John-Wright-alt/hospital_robot/hospital_robot_description/meshes/lidar.stl

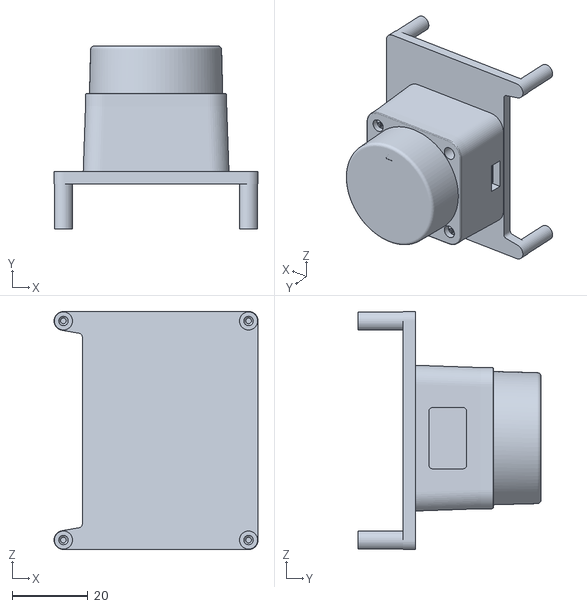
[picture p1: CAD file, 2026-09-20]
hospital_robot_description/meshes/lidar.stl
54.0 x 48.5 x 63.0
