John-Wright-alt/hospital_robot/hospital_robot_description/meshes/base_link.stl

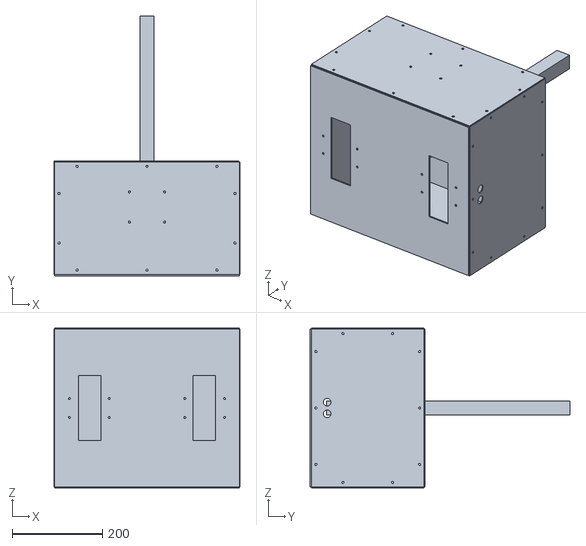
[picture p2: CAD file, 2026-09-20]
hospital_robot_description/meshes/base_link.stl
412.0 x 576.5 x 354.0
