John-Wright-alt/hospital_robot/hospital_robot_description/meshes/camera.stl

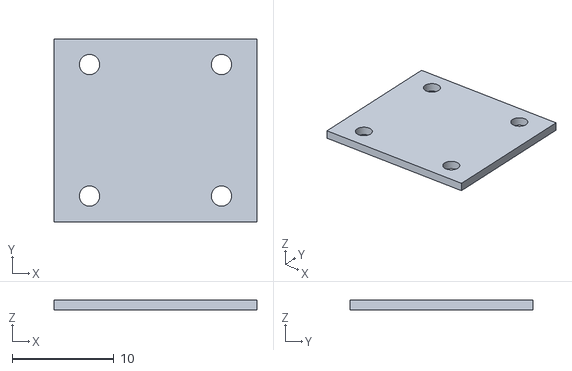
[picture p3: CAD file, 2026-09-20]
hospital_robot_description/meshes/camera.stl
20.0 x 18.0 x 1.00
