John-Wright-alt/hospital_robot/hospital_robot_description/meshes/caster.stl

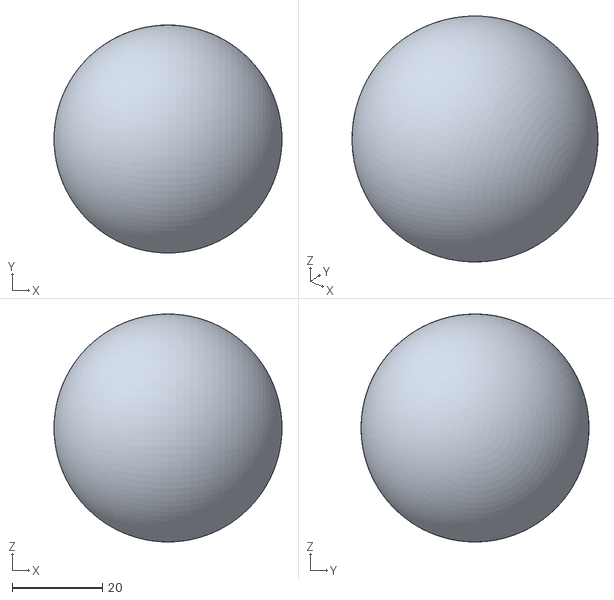
[picture p4: CAD file, 2026-09-20]
hospital_robot_description/meshes/caster.stl
50.5 x 50.5 x 50.5
