John-Wright-alt/hospital_robot/hospital_robot_description/meshes/column.stl

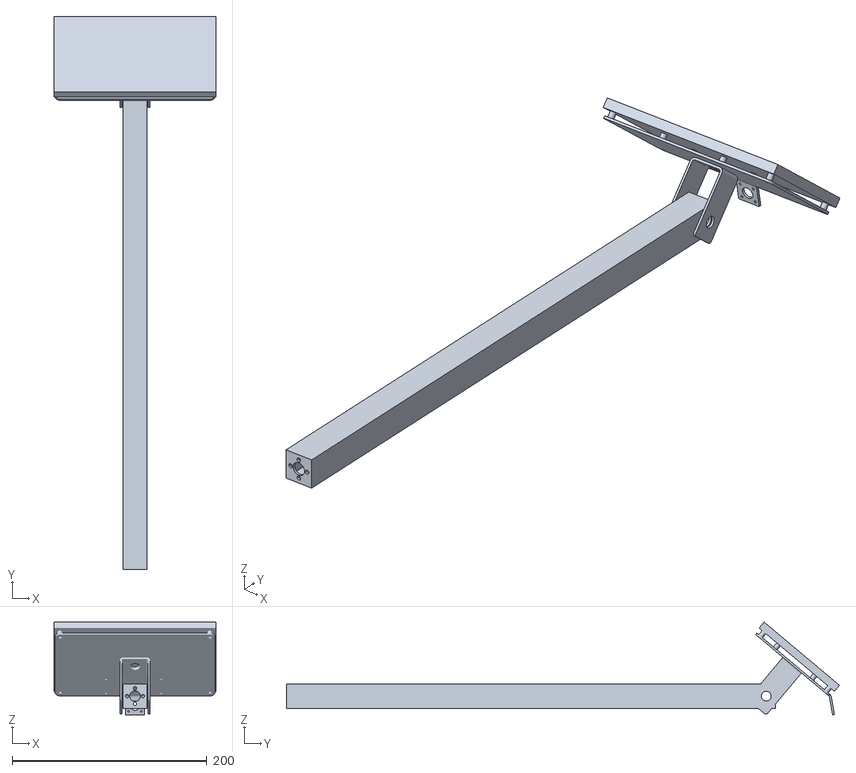
[picture p5: CAD file, 2026-09-20]
hospital_robot_description/meshes/column.stl
166.1 x 568.0 x 95.3
