John-Wright-alt/hospital_robot/hospital_robot_description/meshes/wheel.stl

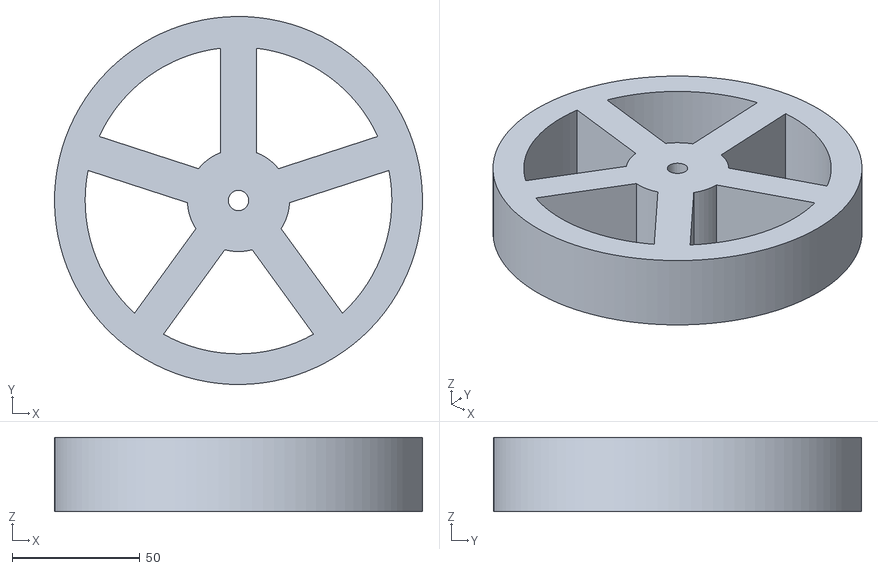
[picture p6: CAD file, 2026-09-20]
hospital_robot_description/meshes/wheel.stl
144.0 x 144.0 x 29.0
