John-Wright-alt/hospital_robot/(commit log)

2026-09-20 Phases 0-5 plus Phase 6 base package
    [base_link.stl, camera.stl, caster.stl, column.stl, hospital_world.sdf, inertial_macros.xacro, lidar.stl, robot.urdf.xacro]
2026-09-23 Phase 8: ESP32 head camera firmware, Pico lift firmware 1.1.0, head_column ROS node, guide
2026-09-23 LiDAR yaw from bench test
    [robot.urdf.xacro]
2026-10-14 Phase 9: lidar_gaze + eyes (hospital_robot_hri)
    [robot.urdf.xacro]
2026-10-17 Phase 9: Anna - voice, wake-up flow, menu (mirror: false and LiDAR respawn kept)
2026-10-17 hri_speech: fix start-up crash; ignore /odom speed while motors have no power
2026-10-19 Phase 7: measured ultrasonic positions
    [robot.urdf.xacro, ultrasonic.xacro]
2026-10-19 base.launch: respawn LD06; ultrasonic topics reliable
2026-10-19 Pico firmware 1.2.0: ultrasonic sensors
2026-10-21 Final: Phase 7 navigation, ultrasonics, HRI trip flow, maps
2026-10-21 Final firmware (Pico 1.2.0, ESP32), passwords removed
